TVavrinec/Servio-PCB/mainBoard/mainBoard.kicad_pcb

## KiCad design mainBoard/mainBoard.kicad_pcb (2025-09-05)

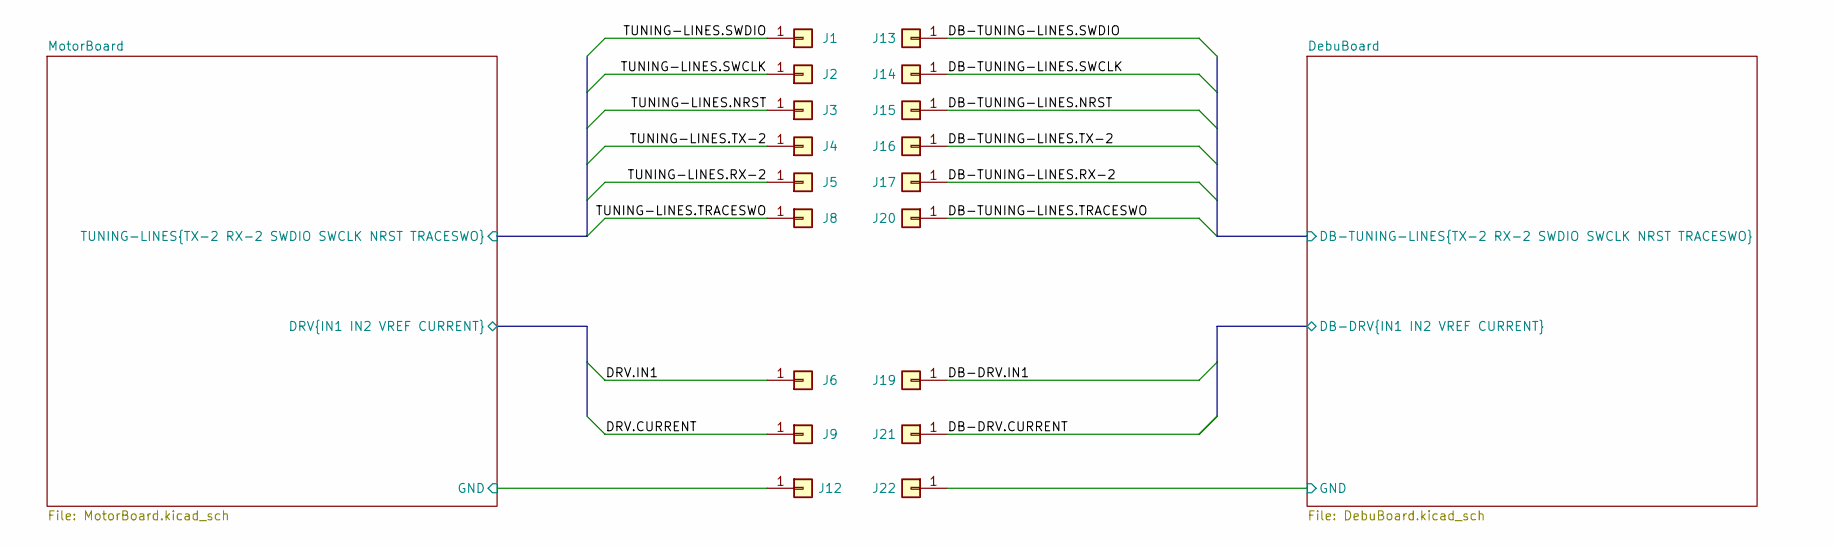
[picture p1: schematic mainBoard.kicad_sch]

Parts:
J1, J2, J3, J4, J5, J6, J8, J9, J12: Conn_01x01; YZ157015035P-01-contact_pad; JLCPCB_IGNORE 1
J13, J14, J15, J16, J17, J19, J20, J21, J22: Conn_01x01; YZ157015035P-01; LCSC C5157325

Connections:
/DebuBoard/DB-DRV.CURRENT: J21.1; also elsewhere on the board
/DebuBoard/DB-DRV.IN1: J19.1; also elsewhere on the board
/DebuBoard/DB-TUNING-LINES.NRST: J15.1; also elsewhere on the board
/DebuBoard/DB-TUNING-LINES.RX-2: J17.1; also elsewhere on the board
/DebuBoard/DB-TUNING-LINES.SWCLK: J14.1; also elsewhere on the board
/DebuBoard/DB-TUNING-LINES.SWDIO: J13.1; also elsewhere on the board
/DebuBoard/DB-TUNING-LINES.TRACESWO: J20.1; also elsewhere on the board
/DebuBoard/DB-TUNING-LINES.TX-2: J16.1; also elsewhere on the board
/DebuBoard/GND: J22.1; also elsewhere on the board
/MotorBoard/DRV.CURRENT: J9.1; also elsewhere on the board
/MotorBoard/DRV.IN1: J6.1; also elsewhere on the board
/MotorBoard/TUNING-LINES.NRST: J3.1; also elsewhere on the board
/MotorBoard/TUNING-LINES.RX-2: J5.1; also elsewhere on the board
/MotorBoard/TUNING-LINES.SWCLK: J2.1; also elsewhere on the board
/MotorBoard/TUNING-LINES.SWDIO: J1.1; also elsewhere on the board
/MotorBoard/TUNING-LINES.TRACESWO: J8.1; also elsewhere on the board
/MotorBoard/TUNING-LINES.TX-2: J4.1; also elsewhere on the board
GND: J12.1; also elsewhere on the board

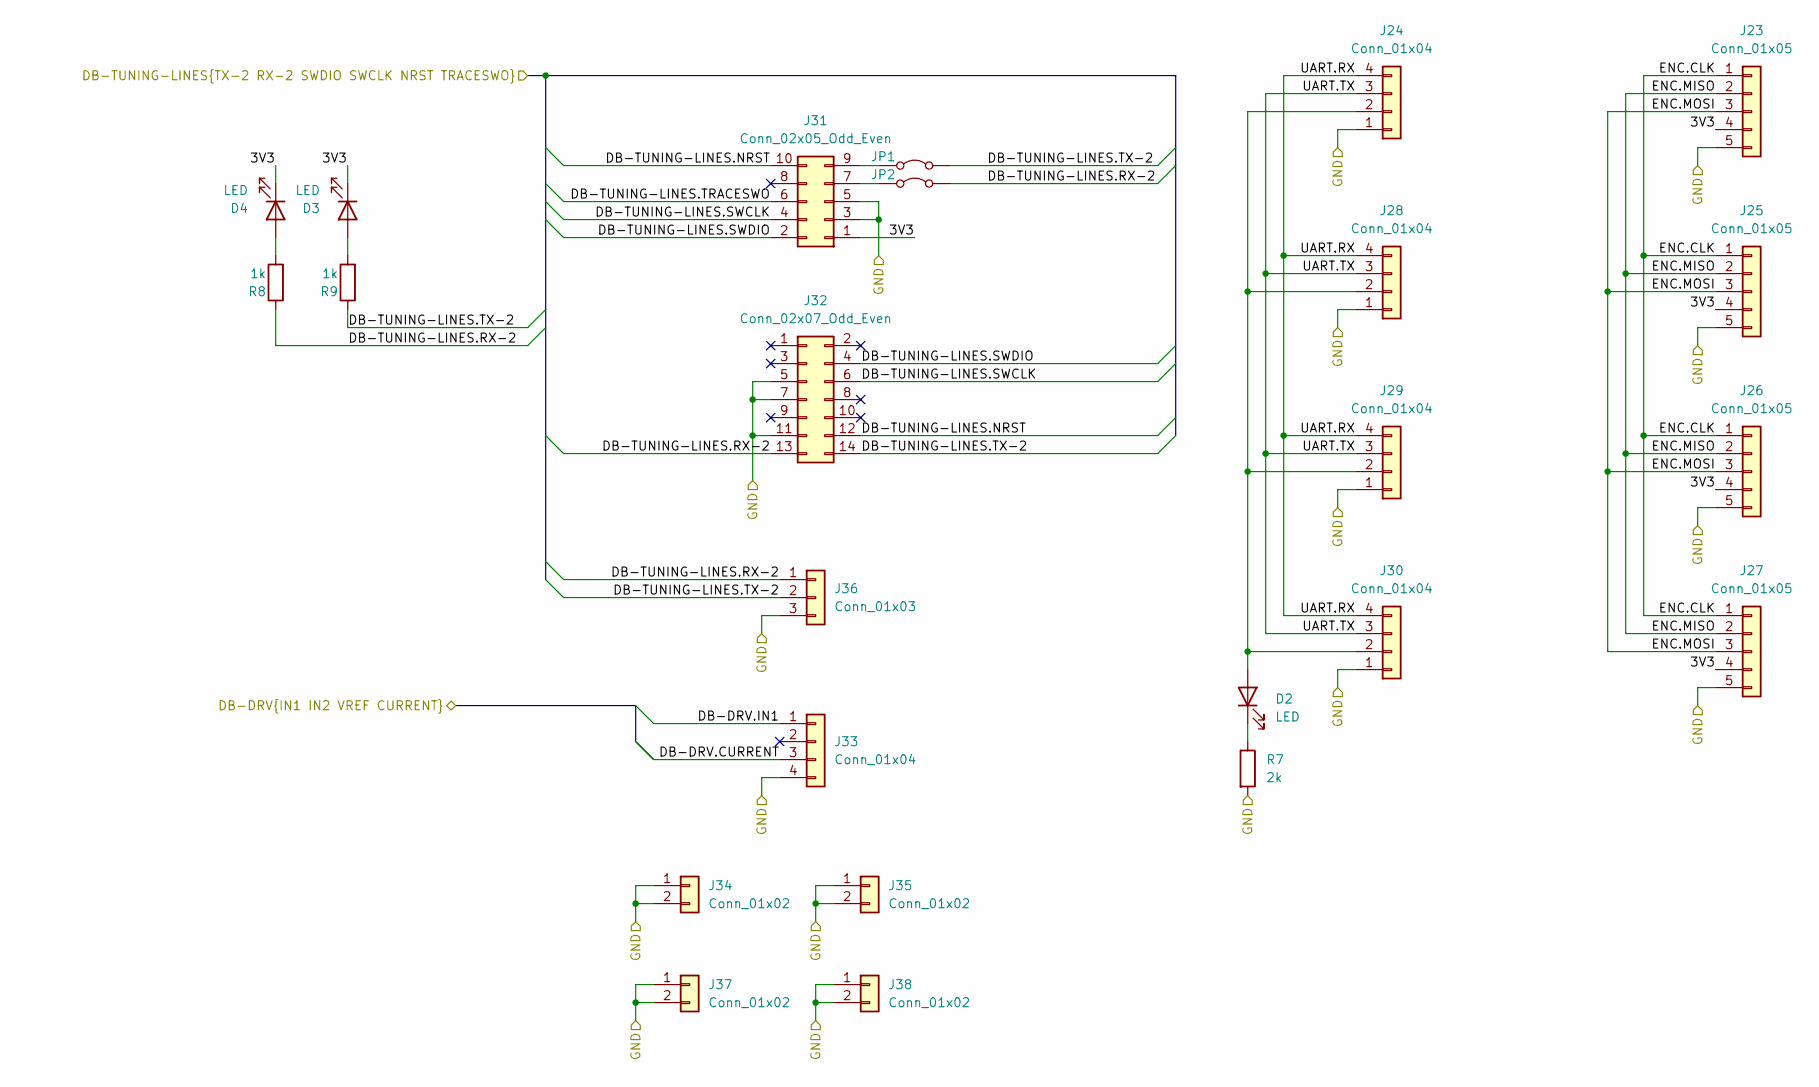
[picture p2: schematic DebuBoard.kicad_sch]

Parts:
D2, D3, D4: LED; LED_0603_1608Metric; LCSC C7496820
J23, J25, J26, J27: Conn_01x05; PinHeader_1x05_P2.00mm_Vertical; LCSC C7501286
J24, J28, J29, J30: Conn_01x04; JST_PH_B4B-PH-K_1x04_P2.00mm_Vertical; LCSC C20598724
J31: Conn_02x05_Odd_Even; PinHeader_2x05_P1.27mm_Vertical; LCSC C239059
J32: Conn_02x07_Odd_Even; PinHeader_2x07_P1.27mm_Vertical; LCSC C783845
J33: Conn_01x04; PinHeader_1x04_P2.54mm_Vertical; LCSC C2691448
J34, J35, J37, J38: Conn_01x02; PinHeader_1x02_P2.54mm_Vertical; LCSC C492401
J36: Conn_01x03; PinHeader_1x03_P2.54mm_Vertical; LCSC C49257
JP1, JP2: Jumper_2_Bridged; SolderJumper-2_P1.3mm_Open_TrianglePad1.0x1.5mm
R7: 2k; C_0603_1608Metric; LCSC C22975
R8, R9: 1k; C_0603_1608Metric; LCSC C21190

Connections:
/DebuBoard/3V3: D3.1 (K), D4.1 (K), J23.4, J25.4, J26.4, J27.4, J31.1
/DebuBoard/DB-DRV.CURRENT: J33.3; also elsewhere on the board
/DebuBoard/DB-DRV.IN1: J33.1; also elsewhere on the board
/DebuBoard/DB-TUNING-LINES.NRST: J31.10, J32.12; also elsewhere on the board
/DebuBoard/DB-TUNING-LINES.RX-2: J32.13, J36.1, JP2.2 (B), R8.1; also elsewhere on the board
/DebuBoard/DB-TUNING-LINES.SWCLK: J31.4, J32.6; also elsewhere on the board
/DebuBoard/DB-TUNING-LINES.SWDIO: J31.2, J32.4; also elsewhere on the board
/DebuBoard/DB-TUNING-LINES.TRACESWO: J31.6; also elsewhere on the board
/DebuBoard/DB-TUNING-LINES.TX-2: J32.14, J36.2, JP1.2 (B), R9.1; also elsewhere on the board
/DebuBoard/ENC.CLK: J23.1, J25.1, J26.1, J27.1
/DebuBoard/ENC.MISO: J23.2, J25.2, J26.2, J27.2
/DebuBoard/ENC.MOSI: J23.3, J25.3, J26.3, J27.3
/DebuBoard/GND: J23.5, J24.1, J25.5, J26.5, J27.5, J28.1, J29.1, J30.1, J31.3, J31.5, J32.5, J32.7, J32.11, J33.4, J34.1, J34.2, J35.1, J35.2, J36.3, J37.1, J37.2, J38.1, J38.2, R7.2; also elsewhere on the board
/DebuBoard/UART.RX: J24.4, J28.4, J29.4, J30.4
/DebuBoard/UART.TX: J24.3, J28.3, J29.3, J30.3
unnamed: D2.2 (A), J24.2, J28.2, J29.2, J30.2
unnamed: D2.1 (K), R7.1
unnamed: D3.2 (A), R9.2
unnamed: D4.2 (A), R8.2
unnamed: J31.7, JP2.1 (A)
unnamed: J31.9, JP1.1 (A)

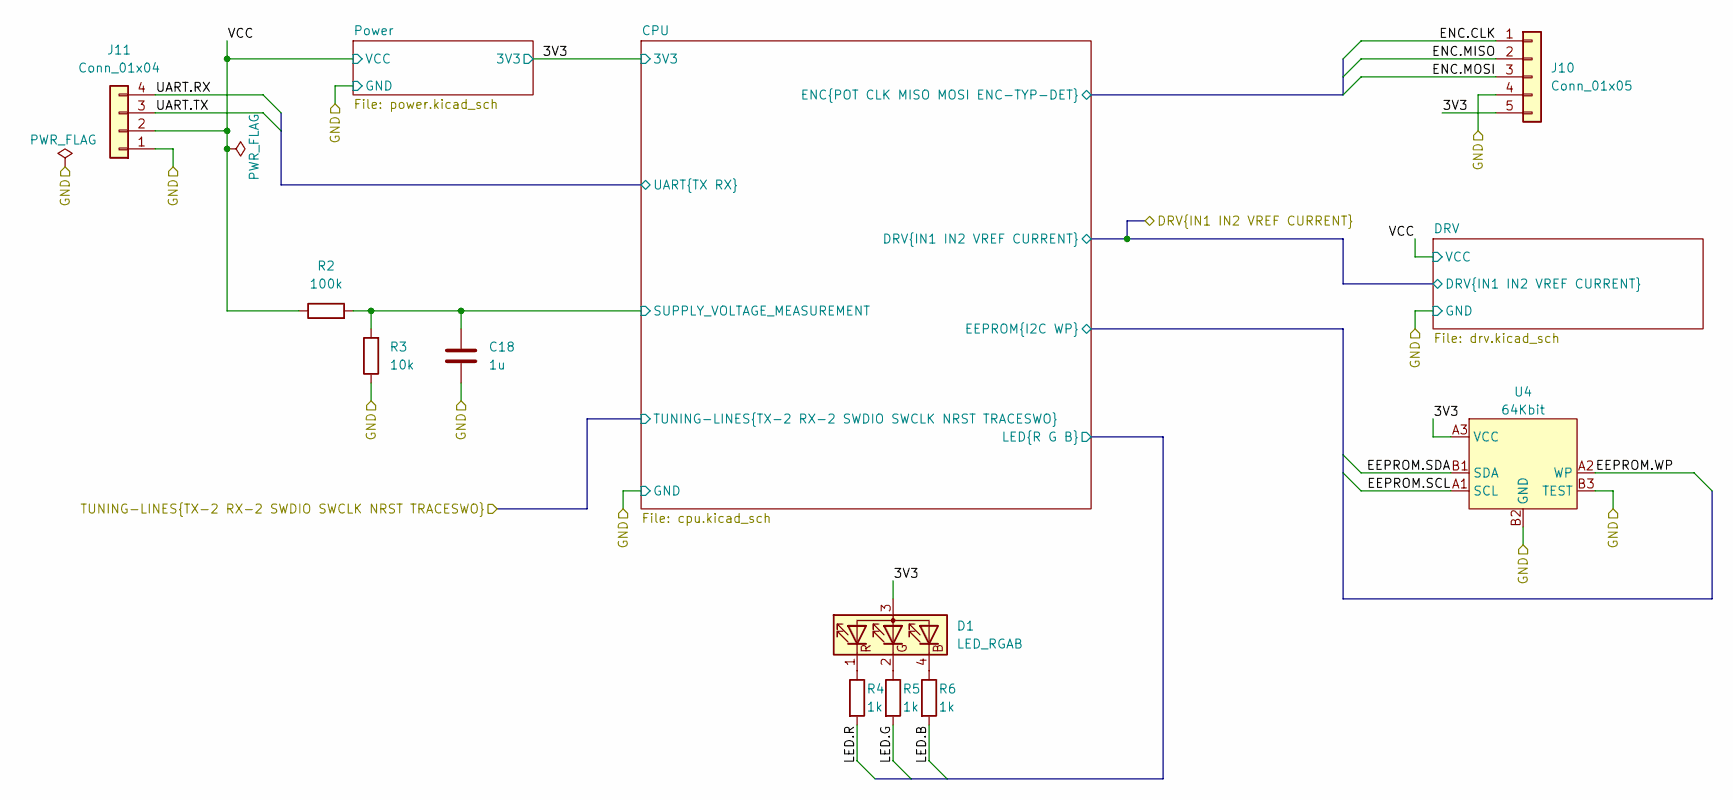
[picture p3: schematic MotorBoard.kicad_sch]

Parts:
C18: 1u; C_0402_1005Metric; LCSC C52923
D1: LED_RGAB; LED_LiteOn_LTST-C19HE1WT; LCSC C965840
J10: Conn_01x05; PinHeader_1x05_P2.00mm_Vertical; LCSC C7501286
J11: Conn_01x04; JST_PH_B4B-PH-K_1x04_P2.00mm_Vertical; LCSC C20598724
R2: 100k; R_0201_0603Metric; LCSC C320497
R3: 10k; R_0201_0603Metric; LCSC C473048
R4, R5, R6: 1k; C_0201_0603Metric; LCSC C138165
U4: 64Kbit; XFBGA-6; LCSC C123068

Connections:
/MotorBoard/CPU/EEPROM.SCL: U4.A1 (SCL); also elsewhere on the board
/MotorBoard/CPU/EEPROM.SDA: U4.B1 (SDA); also elsewhere on the board
/MotorBoard/CPU/EEPROM.WP: U4.A2 (WP); also elsewhere on the board
/MotorBoard/CPU/ENC.CLK: J10.1; also elsewhere on the board
/MotorBoard/CPU/ENC.MISO: J10.2; also elsewhere on the board
/MotorBoard/CPU/ENC.MOSI: J10.3; also elsewhere on the board
/MotorBoard/CPU/LED.B: R6.2; also elsewhere on the board
/MotorBoard/CPU/LED.G: R5.2; also elsewhere on the board
/MotorBoard/CPU/LED.R: R4.2; also elsewhere on the board
/MotorBoard/CPU/SUPPLY_VOLTAGE_MEASUREMENT: C18.1, R2.2, R3.2; also elsewhere on the board
/MotorBoard/CPU/UART.RX: J11.4; also elsewhere on the board
/MotorBoard/CPU/UART.TX: J11.3; also elsewhere on the board
/MotorBoard/VCC: J11.2, R2.1; also elsewhere on the board
GND: C18.2, J10.4, J11.1, R3.1, U4.B2 (GND), U4.B3 (TEST); also elsewhere on the board
unnamed: D1.4 (BK), R6.1
unnamed: D1.2 (GK), R5.1
unnamed: D1.1 (RK), R4.1
VDD: D1.3 (A), J10.5, U4.A3 (VCC); also elsewhere on the board

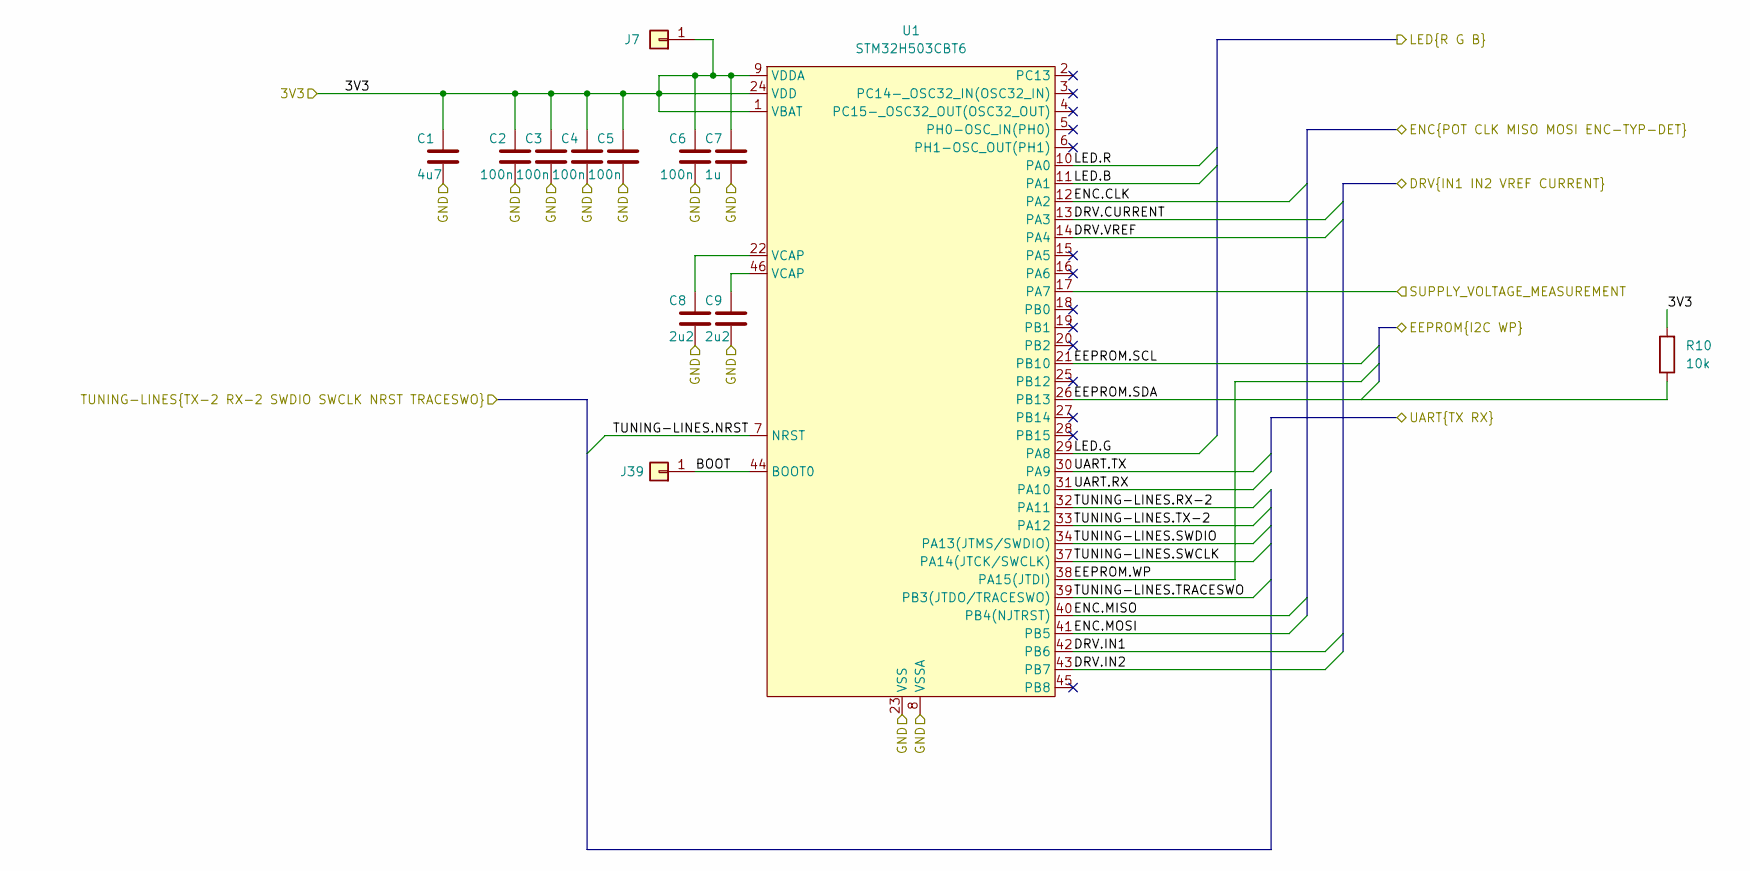
[picture p4: schematic cpu.kicad_sch]

Parts:
C1: 4u7; C_0402_1005Metric; LCSC C23733
C2, C3, C4, C5, C6: 100n; C_0201_0603Metric; LCSC C76934
C7: 1u; C_0402_1005Metric; LCSC C52923
C8, C9: 2u2; C_0402_1005Metric; LCSC C342966
J7, J39: Conn_01x01; YZ157015035P-01-contact_pad; JLCPCB_IGNORE 1
R10: 10k; R_0201_0603Metric; LCSC C473048
U1: STM32H503CBT6; LQFP-48_7x7mm_P0.5mm; LCSC C17700273

Connections:
/MotorBoard/CPU/BOOT: J39.1, U1.44 (BOOT0)
/MotorBoard/CPU/EEPROM.SCL: U1.21 (PB10); also elsewhere on the board
/MotorBoard/CPU/EEPROM.SDA: R10.1, U1.26 (PB13); also elsewhere on the board
/MotorBoard/CPU/EEPROM.WP: U1.38 (PA15(JTDI)); also elsewhere on the board
/MotorBoard/CPU/ENC.CLK: U1.12 (PA2); also elsewhere on the board
/MotorBoard/CPU/ENC.MISO: U1.40 (PB4(NJTRST)); also elsewhere on the board
/MotorBoard/CPU/ENC.MOSI: U1.41 (PB5); also elsewhere on the board
/MotorBoard/CPU/LED.B: U1.11 (PA1); also elsewhere on the board
/MotorBoard/CPU/LED.G: U1.29 (PA8); also elsewhere on the board
/MotorBoard/CPU/LED.R: U1.10 (PA0); also elsewhere on the board
/MotorBoard/CPU/SUPPLY_VOLTAGE_MEASUREMENT: U1.17 (PA7); also elsewhere on the board
/MotorBoard/CPU/UART.RX: U1.31 (PA10); also elsewhere on the board
/MotorBoard/CPU/UART.TX: U1.30 (PA9); also elsewhere on the board
/MotorBoard/DRV.CURRENT: U1.13 (PA3); also elsewhere on the board
/MotorBoard/DRV.IN1: U1.42 (PB6); also elsewhere on the board
/MotorBoard/DRV.IN2: U1.43 (PB7); also elsewhere on the board
/MotorBoard/DRV.VREF: U1.14 (PA4); also elsewhere on the board
/MotorBoard/TUNING-LINES.NRST: U1.7 (NRST); also elsewhere on the board
/MotorBoard/TUNING-LINES.RX-2: U1.32 (PA11); also elsewhere on the board
/MotorBoard/TUNING-LINES.SWCLK: U1.37 (PA14(JTCK/SWCLK)); also elsewhere on the board
/MotorBoard/TUNING-LINES.SWDIO: U1.34 (PA13(JTMS/SWDIO)); also elsewhere on the board
/MotorBoard/TUNING-LINES.TRACESWO: U1.39 (PB3(JTDO/TRACESWO)); also elsewhere on the board
/MotorBoard/TUNING-LINES.TX-2: U1.33 (PA12); also elsewhere on the board
GND: C1.2, C2.2, C3.2, C4.2, C5.2, C6.2, C7.2, C8.2, C9.2, U1.8 (VSSA), U1.23 (VSS), U1.35 (VSS), U1.47 (VSS); also elsewhere on the board
unnamed: C8.1, U1.22 (VCAP)
unnamed: C9.1, U1.46 (VCAP)
VDD: C1.1, C2.1, C3.1, C4.1, C5.1, C6.1, C7.1, J7.1, R10.2, U1.1 (VBAT), U1.9 (VDDA), U1.24 (VDD), U1.36 (VDD), U1.48 (VDD); also elsewhere on the board

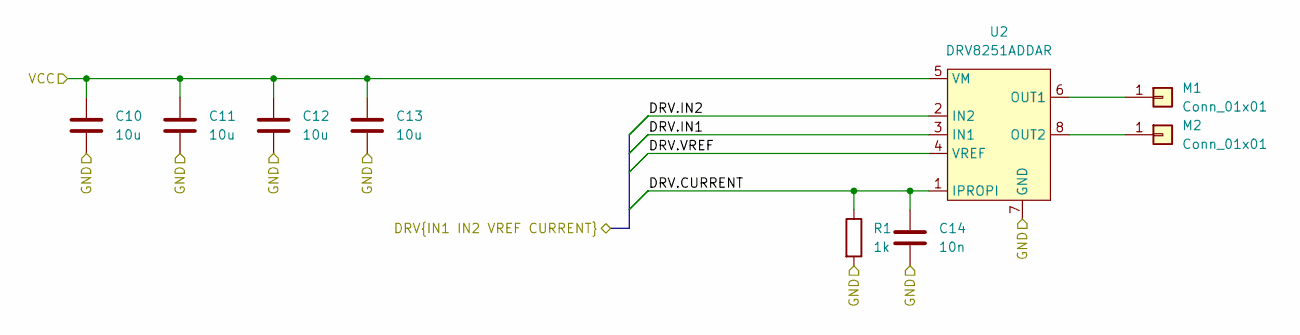
[picture p5: schematic drv.kicad_sch]

Parts:
C10, C11, C12, C13: 10u; C_0603_1608Metric; LCSC C194427
C14: 10n; C_0201_0603Metric; LCSC C285010
M1, M2: Conn_01x01; YZ157015035P-01-contact_pad; JLCPCB_IGNORE 1
R1: 1k; C_0201_0603Metric; LCSC C138165
U2: DRV8251ADDAR; SOIC-8-1EP_3.9x4.9mm_P1.27mm_EP2.62x3.51mm_ThermalVias; LCSC C5218844

Connections:
/MotorBoard/DRV.CURRENT: C14.1, R1.1, U2.1 (IPROPI); also elsewhere on the board
/MotorBoard/DRV.IN1: U2.3 (IN1); also elsewhere on the board
/MotorBoard/DRV.IN2: U2.2 (IN2); also elsewhere on the board
/MotorBoard/DRV.VREF: U2.4 (VREF); also elsewhere on the board
/MotorBoard/VCC: C10.1, C11.1, C12.1, C13.1, U2.5 (VM); also elsewhere on the board
GND: C10.2, C11.2, C12.2, C13.2, C14.2, R1.2, U2.7 (GND), U2.9 (GND); also elsewhere on the board
unnamed: M1.1, U2.6 (OUT1)
unnamed: M2.1, U2.8 (OUT2)

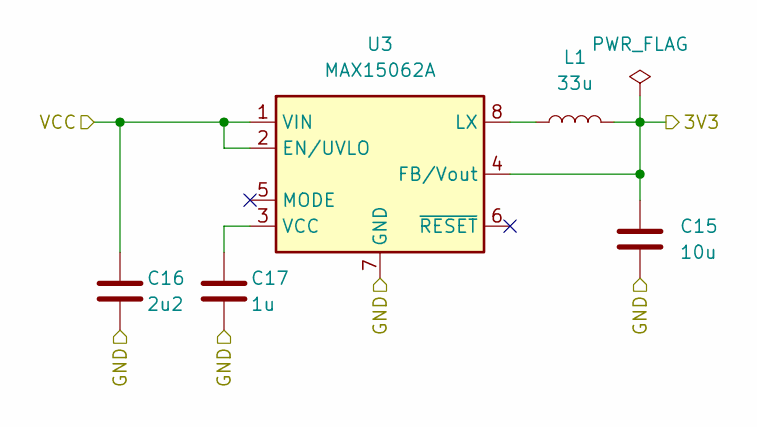
[picture p6: schematic power.kicad_sch]

Parts:
C15: 10u; C_0603_1608Metric; LCSC C194427
C16: 2u2; C_0402_1005Metric; LCSC C342966
C17: 1u; C_0402_1005Metric; LCSC C52923
L1: 33u; L_1008_2520Metric; LCSC C223363
U3: MAX15062A; DFN-8_2x2mm_P0.5mm; LCSC C2846801

Connections:
/MotorBoard/VCC: C16.1, U3.1 (VIN), U3.2 (EN/UVLO); also elsewhere on the board
GND: C15.2, C16.2, C17.2, U3.7 (GND); also elsewhere on the board
unnamed: L1.1, U3.8 (LX)
unnamed: C17.1, U3.3 (VCC)
VDD: C15.1, L1.2, U3.4 (FB/Vout); also elsewhere on the board

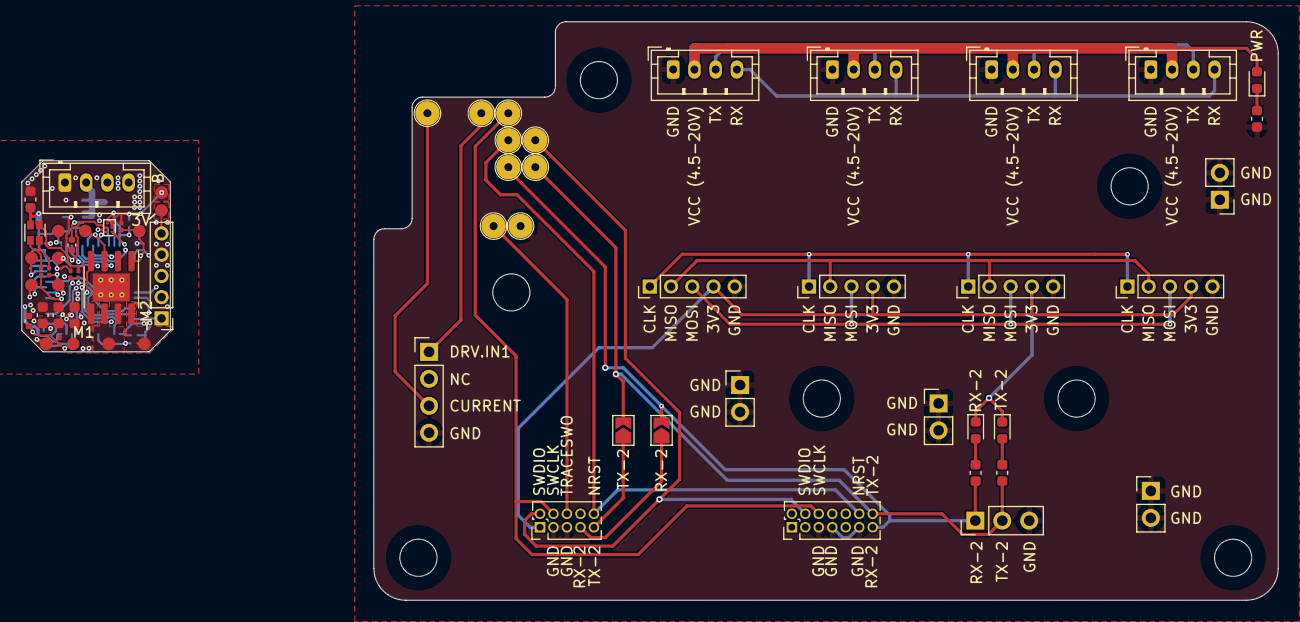
[picture p7: board mainBoard.kicad_pcb from above]

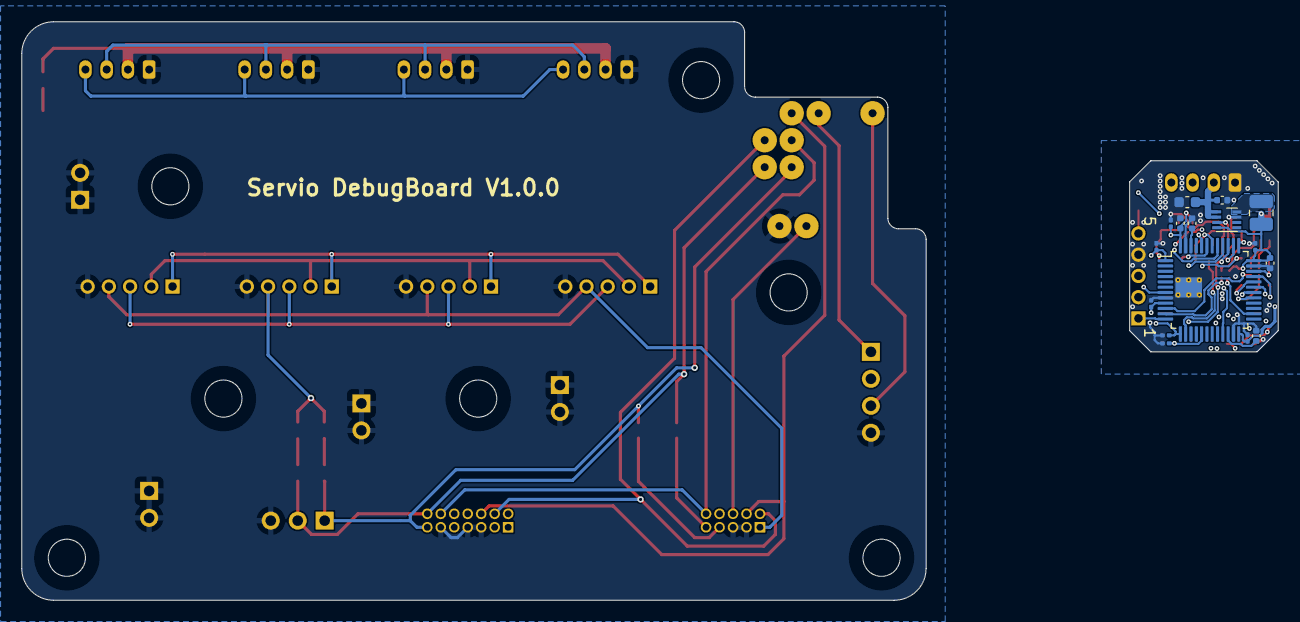
[picture p8: board mainBoard.kicad_pcb from below]

Board: 4 copper layers, 118.4 x 54.5 mm, 79 parts (16 on the bottom side), 56 nets.
