TVavrinec/Servio-PCB/(threads)

Thread 2 (2024-03-10):

J7 Is small

koniarik, 2024-03-10:
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

The connector in picture is in reality quite small, small enough to make hand soldering unpleasant. I think that this is out of scope of what I would expect for "average hobby person" to be able to solder comfortably.

I would like to try to devise a different solution that is easier to handsolder.

There are few options:
1. Use a pin header with bigger pitch. With current pitch the holes are close together and that is uncomfortable.
2. Devise a way to make fewer pins in the connector:
     - `enc-type-detect` could be just a solder jumper on surface I think? (that things are easy to solder by anybody)
3. Do not treat potentiometer and encoder the same (rationale: I don't mind assuming that people using SPI can solder better than people that want potentiometer) :
     - We can use bigger holes or castelated pins for pins used only for potentiometer
     - Use smaller pin header for SPI/quadrature encoder

 For reference, here is 1x6 pin header with 2mm pitch next to current solution:

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

Closed 2025-02-27.

Thread 3 (2024-03-10):

Split debug connector for external sensors

koniarik, 2024-03-10:
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

To be able to connect the potentiometer on connector to the board, I had to resort to using wires between the connector and the one we have on PCB, only because the pins are too apart from each other.

Suggestions: How about we split J6 into multiple connectors, one for each variant of external sensor?
(Only on debug board)

TVavrinec, 2024-03-10:
Yes, it sounds like a good idea

Closed 2025-03-13.

Thread 4 (2024-03-10):

Attach debugger directly to the board.

koniarik, 2024-03-10:
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

We designed this to connect the debugger via cable to the board being debugged. On prototype I realized that this is just waste of space, as we could just put female pin headers on the debug board and connect the debugger directly.

P.S: If we minimize space required by the whole setup it's easier to setup "small" testjigs. Which is necessary to be able to have a lot of them.

TVavrinec, 2024-03-10:
Well, it's a good idea, it's just a matter of soldering the female pin headers, no need to change the PCB.

koniarik, 2024-03-10:
> Well, it's a good idea, it's just a matter of soldering the female pin headers, no need to change the PCB.

There is no need for mirroring or something? coool

TVavrinec, 2024-03-10:
Yes, the cabin doesn't change the position of the signals.
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

Closed 2025-02-27.

Thread 5 (2024-03-29):

Missing LEDs

koniarik, 2024-03-29:
As a limitations I did not realized it would be nice to ADD following leds _on debug board_: (The mainboard is fine)
 - led that power is on
    - it should be fine if it would be on VDD not VCC
  - leds for debug rx/tx

Closed 2025-02-27.

Thread 6 (2024-03-29):

Debug connector for BMP

koniarik, 2024-03-29:
Warning: This is not yet confirmed that we want it

For compability with other debuggers than just ST stuff we might want more debug connectivity, it should be ok to just have un-used connector pinouts on the board I guess. Taking this as inspiration: https://black-magic.org/knowledge/pinouts.html

- keep the STDC14
- add ARM Cortex 10pin Debug Connector
- add standalone connector for debug UART
- route TRACESWO(8) pin if possible

optionally:
- if we could add the black magic connector (BMDU), it might be nice and it should be esay as it overlaps ARM 10pin - so just add pins for jumpers to connect rx/tx to the connector? (note: definetly do not waste too much time on this, just try it)
-

koniarik, 2025-02-27:
Observations from v3:

BMDU is nice connector, but having direct connection between BMDU AND external UART won't work, as BMDU shrotcuts RX/TX :/

Closed 2025-04-25.

Thread 7 (2024-04-01):

Missing GND for probe

koniarik, 2024-04-01:
Simple issue: I miss a good spot to attach scope probes gnd pin, would be nice to have something on the external debug board.

koniarik, 2025-02-27:
There is enough GND now!

Closed 2025-02-27.

Thread 8 (2024-04-01):

Missing index pin for quadrature encoder

koniarik, 2024-04-01:
STM peripheral has native support for quadrature index pin - it resets absolute position.
This might be necessary in some scenarios

From what I checked this is not currently routed, a free pin with this capability for TIM3 is PA2 which is free, so I guess it could be used if we can put it on encoder header?

To sum it up: we expose PB5, PB4, PB3, we can use it in two configurations:
SPI1/3: MISO, MOSI, CLK
TIM3: TIM3_CH2, TIM3_CH1
If we would switch the PB3 with PA2 we could do PB5,PB4,PA2:
SPI1: MISO, MOSI, CLK
TIM3: TIM3_CH2, TIM3_CH1, TIM3_ETR(index)

Note: this relates to https://github.com/TVavrinec/Servio-PCB/issues/6 as by releasing PB3 from encoder/spi usage we can use it for TRACESWO which might be nice

koniarik, 2025-03-09:
Note: check that PB5/PB4/PA2 combo would also support ADC

Thread 9 (2024-04-05):

Can't easily attach logic probe clips on PWM

koniarik, 2024-04-05:
One of the crucial aspect for analysis on scope is ability to sense PWM pins (IN1/IN2), this is kinda pain in teh arse now as only thing available are the pins on the HBridge, which I constantly fail to sense without touching pins around it.

It would be nice to find a way to sense those two PINS

koniarik, 2025-02-27:
PIns should be ok now

Closed 2025-02-27.

Thread 10 (2024-05-08):

PCB Shape is a bit off

koniarik, 2024-05-08:
The PCB shape is a bit off, overall length/width is OK, but the cutout does not fit.

The width of the "front" side is 12mm, but should've been 11mm instead.

The cutout is done with circles centered in the corner of rectangular shape, that does not fit exactly, as the holes in the servo does not have centers in the corners but a bit inside.

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

P.S: Obviously it would be better to pass the prototype for this :)

koniarik, 2024-05-08:
Extra food for thought:

The cutted "bridges" leave copper behind themselves, the prototype servo I am using has _metal walls_, I guess that might be an issue? :)

koniarik, 2025-02-27:
New shape is nice

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

Closed 2025-03-14.

Thread 11 (2024-05-08):

Interface connectors - drop from 2 to 1

koniarik, 2024-05-08:
Currently we have two interface connectors (4x1, 1.27mm, JST PH), after some more thought with this:
- It allows chaining of servos, which is _nice_ but not always practical or necessary. one especially has to keep in mind that in case multiple servos are chained, the first one has _all the current_ flowing throu it. Overall nice to have feature but not necessary
- Even if we use 1.27mm connectors, they indeed take a lot of place.

I am thinking that maybe we should use only once connector.

Thing is, I was insisting on this also as a convenience thing for development, as for a lot of testjigs, I use one connector only for power, and one only for comms. (It is quite practical) Thing is, for that I don't need two connectors on the board itself, but two connectors on the _debug board_ surrounding it - this can be avoided entirely.

Closed 2025-02-27.

Thread 12 (2024-05-08):

Increase size of the onboard debug connector

koniarik, 2024-05-08:
We use 3x1 1mm debug connector for flashing when the board is nto attached to the debug board. Frankly? this will be too much painfull to work with.

I suggest that we process rest of the changes and after that we try to fit in bigger "connector", it can still be just 3 holes, just with bigger pitch.

koniarik, 2025-02-27:
We switched to POGO pins, turns out that it works quite well - +- limitations of the pogo pins

Closed 2025-02-27.

Thread 13 (2024-05-11):

Idea: make STM bootloader available over UART

koniarik, 2024-05-11:
STM provides native bootloader for the chips that allow for flashing over standard interaces, more here: https://www.st.com/resource/en/application_note/an2606-stm32-microcontroller-system-memory-boot-mode-stmicroelectronics.pdf

To switch to the bootloader, we would have to devise a way to set Boo0 pin to 1. (surface jumper?)

The interesting part would be to have the main communication UART be on the same ports as one of the UARTS for bootloader - one can flash firmware into servio without the need for debugger.

Map for STM32H5 is:

USART1 - PA10/PA9
USART2 - PA15/PA5
USART3 - PA3/PA4

That is: try to check if it would be OK to move main interface PINS to some combination of these.

koniarik, 2025-02-27:
Missing boot0 on v4

koniarik, 2025-03-14:
We have ot be able to easily connect boot0 with VCC -> USER has to able to do that

koniarik, 2025-04-15:
Ad V4: it works \o/ we can use the bootloader

UX notes:
- At first glance I tried to connect Boot0 with the pad next to it which is GND - this is confusing in the end :/
- I worry that once user solders the J10 connector next to it, the 3v3 pin wont be available anymore

Closed 2025-04-25.

Thread 14 (2024-05-18):

3pin SWD not working

koniarik, 2024-05-18:
I was not able to make the small "three pin header" to work. Thing is I might've fucked up by not flashing at least some firmware before taking the board out of the debug board.

What could've helped: have the reset pin accessible on the main board

koniarik, 2025-02-27:
This is no longer issue with v4

Closed 2025-02-27.

Thread 18 (2024-12-15):

Missing ADC for potentiometer

koniarik, 2024-12-15:
It would be preferable if we could do this in a way that its shared with encoder header

Thread 19 (2025-01-16):

Missing vref on debug board

koniarik, 2025-01-16:
Debug board is missing connection to vref pin which is expected by the debugger.

koniarik, 2025-02-22:
This is worthy solving, the BMP indeed expects it and it kinda makes sense, even for UART!

Closed 2025-04-25.

Thread 20 (2025-02-22):

i2c not working reliably - missing external pullup?

koniarik, 2025-02-22:
So, it turns out that if we try to wiggle the I2C pins manually, SCL works just fine, SDA has issues and won't go up to 3v3 at all.
Note: internal pullup is 40k

If I dropped the EEPROM from the board the pin behaves just fine

koniarik, 2025-08-02:
Solved

Closed 2025-08-02.

Thread 21 (2025-02-27):

Idea: make motor pads bigger/friendly

koniarik, 2025-02-27:
The experience of soldering wires to M1/M2 pins of motor is not greates, it's not really obvious how to "point" the wires - is there some chance to improve it?

koniarik, 2025-04-25:
New pads are just fine

Closed 2025-04-25.

Thread 22 (2025-03-16):

V4 TODO

koniarik, 2025-03-16:
- [] Free PA2 from green LED, attach green LED to free pin (based on what fits), can be pure GPIO
 - [] Change pin configuration for encoder header: PB4, PB5, PA8 -> PB4, PB5, PA2
     - SPI1 config:   PB4-MISO, PB5-MOSI, PA2-SCK
     - TIM3 config:  PB4-CH1,   PB5-CH2,   PA2-ERT(or GPIO)
     - ADC config:   ...............,...............,      PA2-CH14
 - [] Expose `boot0` so _any user_ can shortcut to VCC
     - Users can use this to flash new firmware, let's meake it really easy :)
 - [] On debug board, For BMDU connector (J31) - make TX/RX wiring optional (solder jumper?)
 - [] On debug board: vire VRef (3v3) to the BMDU connector, probe needs it
     - https://black-magic.org/knowledge/pinouts.html#black-magic-debug-unified-connector-bmdu
 - [] Add pullup on I2C SDA line
     - [] Note: Veverak has yet to verify this
 -  [] Increase the size of motorpads, ideally make them as throu holes or just bigger

Thread 23 (2025-08-02):

UX on boot0 pin is not great

koniarik, 2025-08-02:
It's not exactly intuitive especially if we have GND pad next to it which is tempting to use. Hence I propose:
 - Get rid of GND near boot0 pin
 - Just create standalone footprint with 3v3 and boot0 next to each other, avoid the nearby pin
 - Let's add silk marking?
