TVavrinec/Servio-PCB/CubeMX/STM32H503CXXX.ioc

Mcu.UserName=STM32H503CBTx
PA0.GPIO_Label=POT_ADC
PA0.Signal=ADCx_INP0
PA1.Signal=S_TIM2_CH2
PA10.Signal=USART1_RX
PA11.Signal=USART2_RX
PA12.Signal=USART2_TX
PA13(JTMS/SWDIO).Signal=DEBUG_JTMS-SWDIO
PA14(JTCK/SWCLK).Signal=DEBUG_JTCK-SWCLK
PA15(JTDI).GPIO_Label=EEPROM-WP
PA15(JTDI).Signal=GPIO_Output
PA2.Signal=S_TIM3_ETR
PA3.GPIO_Label=CURR_ADC
PA3.Signal=ADCx_INP15
PA4.Signal=COMP_DAC11_group
PA7.Signal=ADCx_INP7
PA9.Signal=USART1_TX
PB10.Signal=S_TIM2_CH3
PB2.Signal=S_TIM2_CH1
PB3(JTDO/TRACESWO).Signal=I2C2_SCL
PB4(NJTRST).Signal=S_TIM3_CH1
PB5.Signal=S_TIM3_CH2
PB6.GPIO_Label=HBRIDGE_A
PB6.Signal=S_TIM1_CH2
PB7.GPIO_Label=HBRIDGE_B
PB7.Signal=S_TIM1_CH1
PB8.Signal=I2C2_SDA
