TVavrinec/Servio-PCB/(commit log)

2023-09-16 V1 feedback
    PWM na LED a měření naoájecího napětí
2023-09-23 Část schématu
    [cpu.kicad_sch, mainBoard.kicad_pcb, mainBoard.kicad_sch, power.kicad_sch]
2023-12-05 LEDky, měření napájení, připojení DRV atd.
    [cpu.kicad_sch, drv.kicad_sch, mainBoard.kicad_pcb, mainBoard.kicad_sch, power.kicad_sch]
2023-12-05 test-pointy a zdvojení konektorů
    [cpu.kicad_sch, drv.kicad_sch, mainBoard.kicad_sch]
2023-12-05 test-point na děliči
    [mainBoard.kicad_sch]
2023-12-05 test-pointy na ENC-POT
    [mainBoard.kicad_sch]
2023-12-24 Lepší GND
    [mainBoard.kicad_pcb]
2023-12-24 happy christmas
    [mainBoard.kicad_pcb]
2023-12-25 Zvetšení test pointů
    [drv.kicad_sch, mainBoard.kicad_pcb, mainBoard.kicad_sch]
2023-12-25 Hrádky s poligony
    [mainBoard.kicad_pcb]
2023-12-28 JST-XH na externí motorový konektor
    [mainBoard.kicad_pcb]
2023-12-28 Moc kondíků
    [cpu.kicad_sch, drv.kicad_sch, mainBoard.kicad_pcb, mainBoard.kicad_sch, power.kicad_sch]
2023-12-29 Otočitelnost
    [mainBoard.kicad_pcb]
2024-01-21 Větší via
    [mainBoard.kicad_pcb]
2024-06-13 drobeček
    [cpu.kicad_sch, drv.kicad_sch, mainBoard.kicad_pcb, mainBoard.kicad_sch, power.kicad_sch]
2024-07-27 Add power LEDs and UART connector
    [DebuBoard.kicad_sch, cpu.kicad_sch, drv.kicad_sch, mainBoard.kicad_pcb, mainBoard.kicad_sch]
2024-07-27 Reducing size of debug board
    [mainBoard.kicad_pcb]
2024-07-27 Fix GND polygon
    [mainBoard.kicad_pcb]
2024-07-27 Mounting holes and recessing the main board
    [mainBoard.kicad_pcb]
2024-08-07 Add LCSC code
    [DebuBoard.kicad_sch, MotorBoard.kicad_sch, mainBoard.kicad_sch]
2024-08-07 Add GND via for better cooling
    [mainBoard.kicad_pcb]
2024-09-05 LCSC cods
    [DebuBoard.kicad_sch, MotorBoard.kicad_sch, drv.kicad_sch, mainBoard.kicad_sch]
2024-11-16 Bigger via
    [mainBoard.kicad_pcb]
2024-11-24 New C1 LCSC cod
    [cpu.kicad_sch]
2025-03-19 Kicad 8 and SDA pullup
    [DebuBoard.kicad_sch, MotorBoard.kicad_sch, cpu.kicad_sch, drv.kicad_sch, mainBoard.kicad_sch, power.kicad_sch]
2025-03-20 SDA pullup add to PCB
    [mainBoard.kicad_pcb]
2025-03-20 Change pin configuration for encoder header
    [cpu.kicad_sch, mainBoard.kicad_pcb]
2025-03-20 Expose boot0 so any user can shortcut to VCC
    [MotorBoard.kicad_sch, cpu.kicad_sch, mainBoard.kicad_pcb]
2025-03-20 On debug board, For BMDU connector (J31) - make TX/RX wiring optional
    [DebuBoard.kicad_sch, mainBoard.kicad_pcb]
2025-03-20 On debug board: vire VRef (3v3) to the BMDU connector
    [DebuBoard.kicad_sch, mainBoard.kicad_pcb]
2025-03-20 Increasing motor pedals
    [DebuBoard.kicad_sch, mainBoard.kicad_pcb, mainBoard.kicad_sch]
2025-09-05 Remove the GND tuning pad and replace them with VDD tuning pads, and update to Kicad 9.0
2026-01-24 dropped spec. added readme and diag (#25)
    * dropped spec. added readme and diag
    * added more dims
    * fixed background
    * basic pin description
